pebarone/carrinho-tinyml/cp2/evidence/edge-impulse/01-impulse.jpg

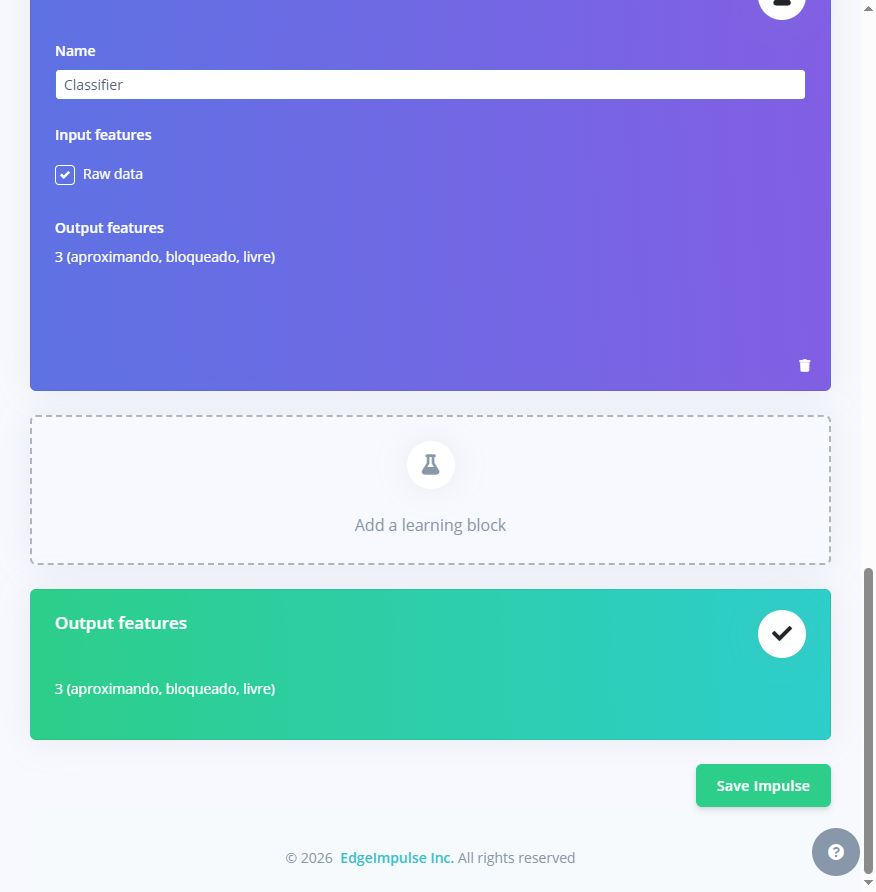
cp2/evidence/edge-impulse/01-impulse.jpg
