pebarone/carrinho-tinyml/cp2/evidence/edge-impulse/02-training.jpg

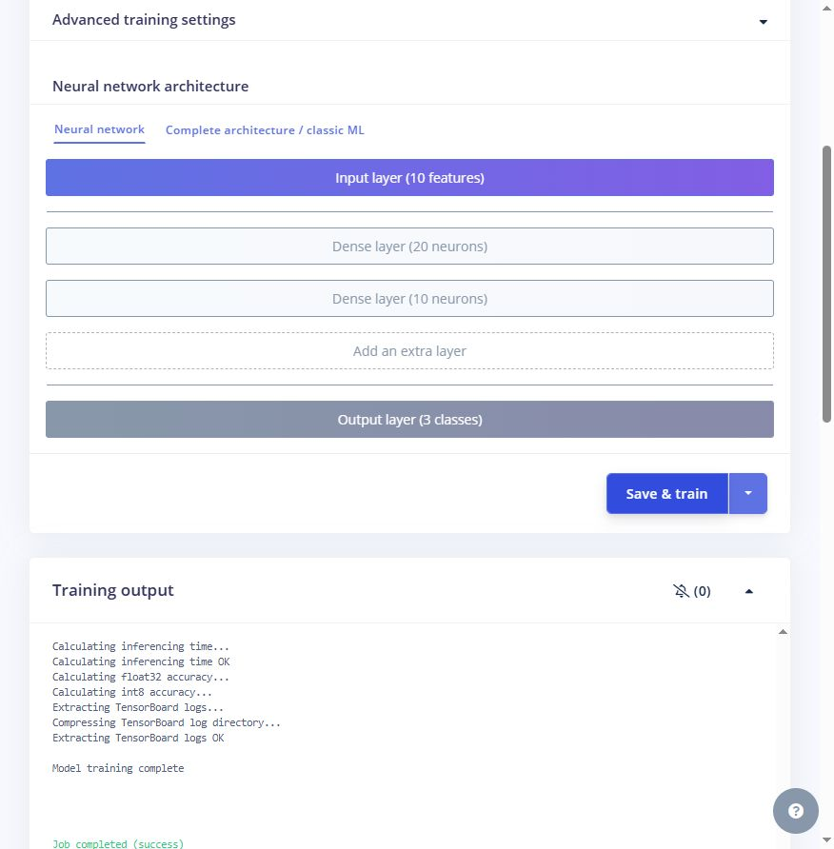
cp2/evidence/edge-impulse/02-training.jpg
