pebarone/carrinho-tinyml/cp2/evidence/real-training-v1/01-projeto-real.png

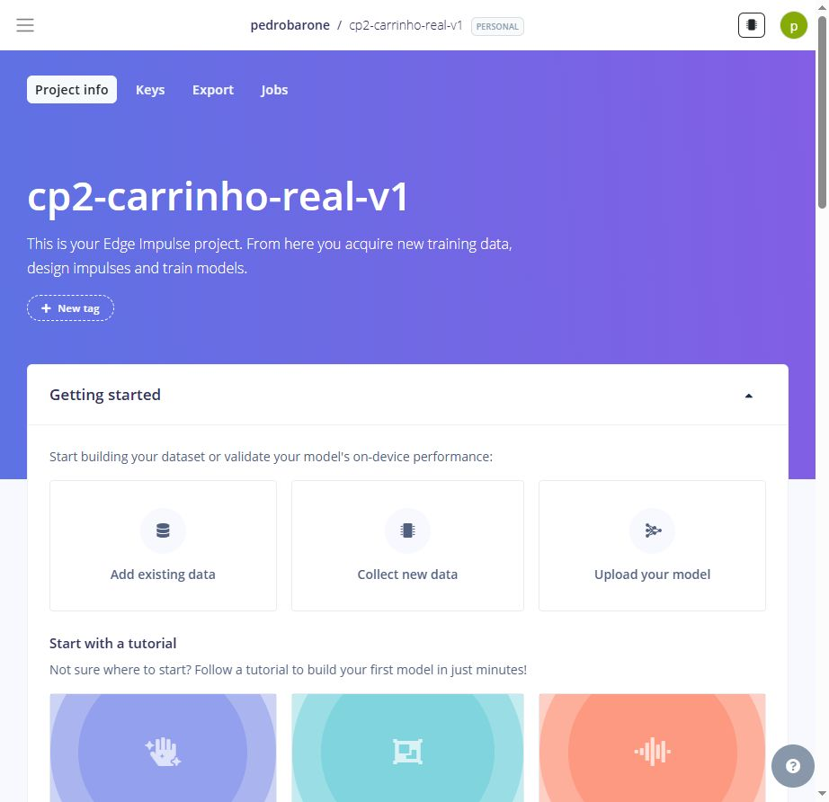
cp2/evidence/real-training-v1/01-projeto-real.png
