pebarone/carrinho-tinyml/cp2/evidence/real-training-v1/02-csv-wizard.png

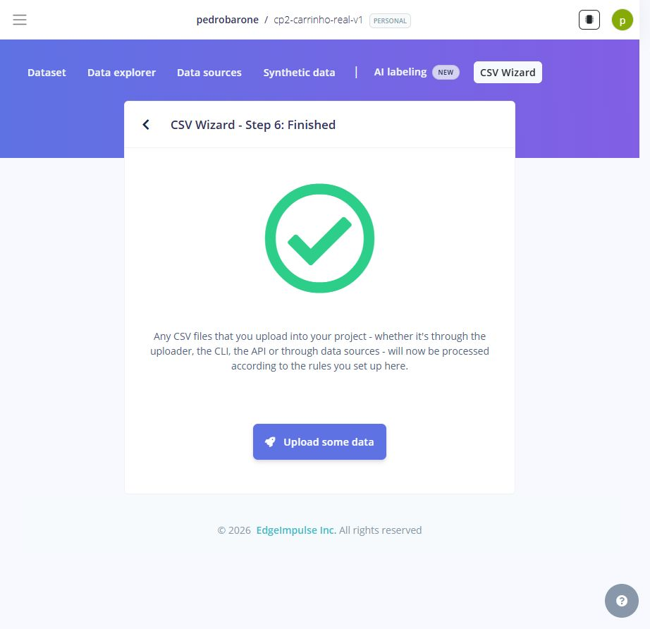
cp2/evidence/real-training-v1/02-csv-wizard.png
