pebarone/carrinho-tinyml/cp2/evidence/real-training-v1/03-dataset-real.png

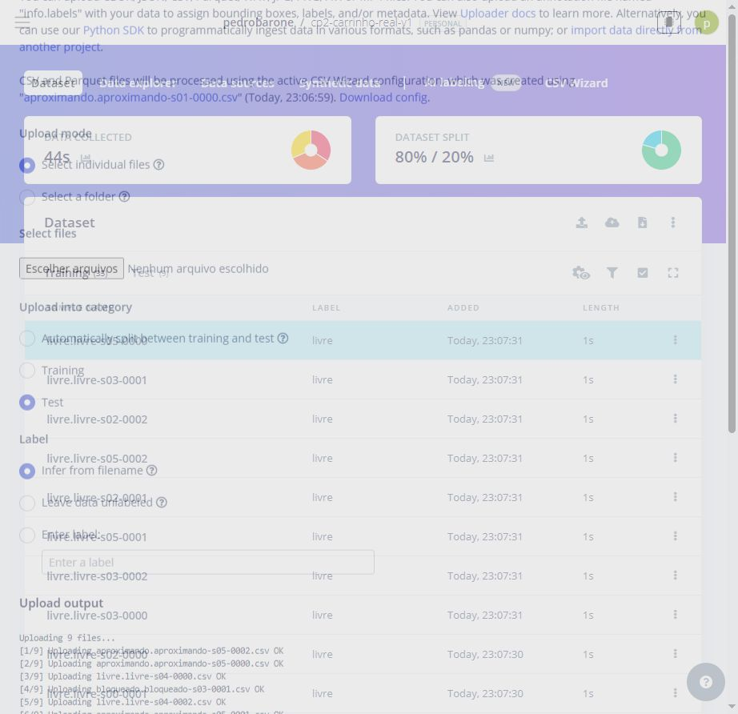
cp2/evidence/real-training-v1/03-dataset-real.png
