pebarone/carrinho-tinyml/cp2/evidence/real-training-v1/05-features.png

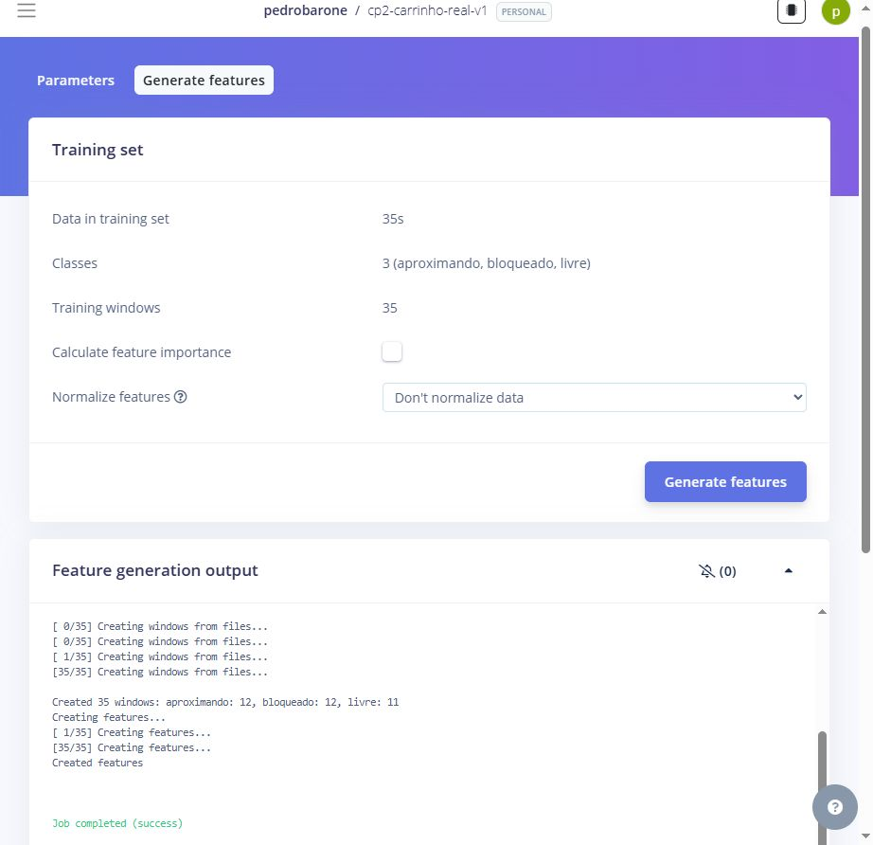
cp2/evidence/real-training-v1/05-features.png
