pebarone/carrinho-tinyml/cp2/evidence/real-training-v1/06-training-settings.png

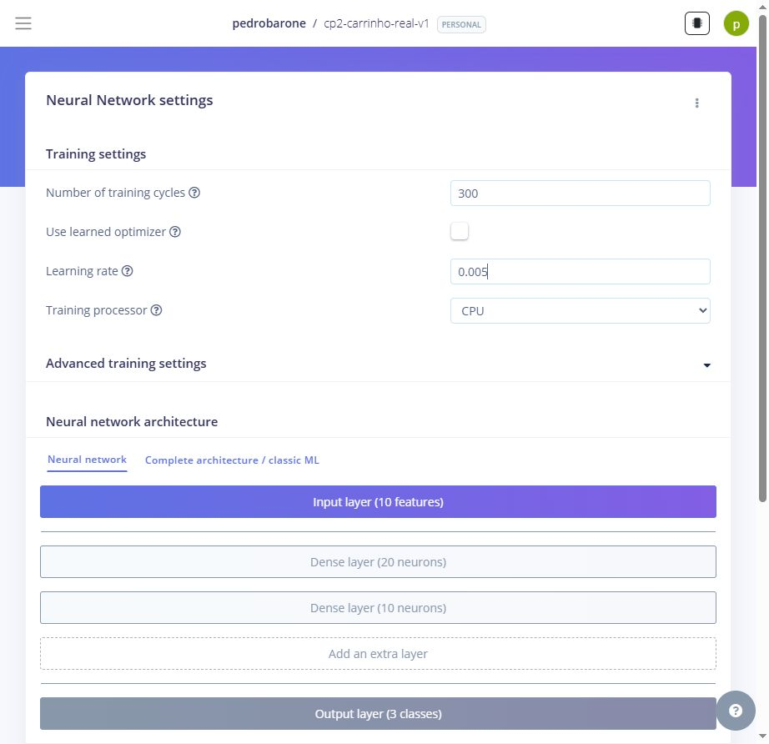
cp2/evidence/real-training-v1/06-training-settings.png
