pebarone/carrinho-tinyml/cp2/evidence/real-training-v1/10-projeto-publico.png

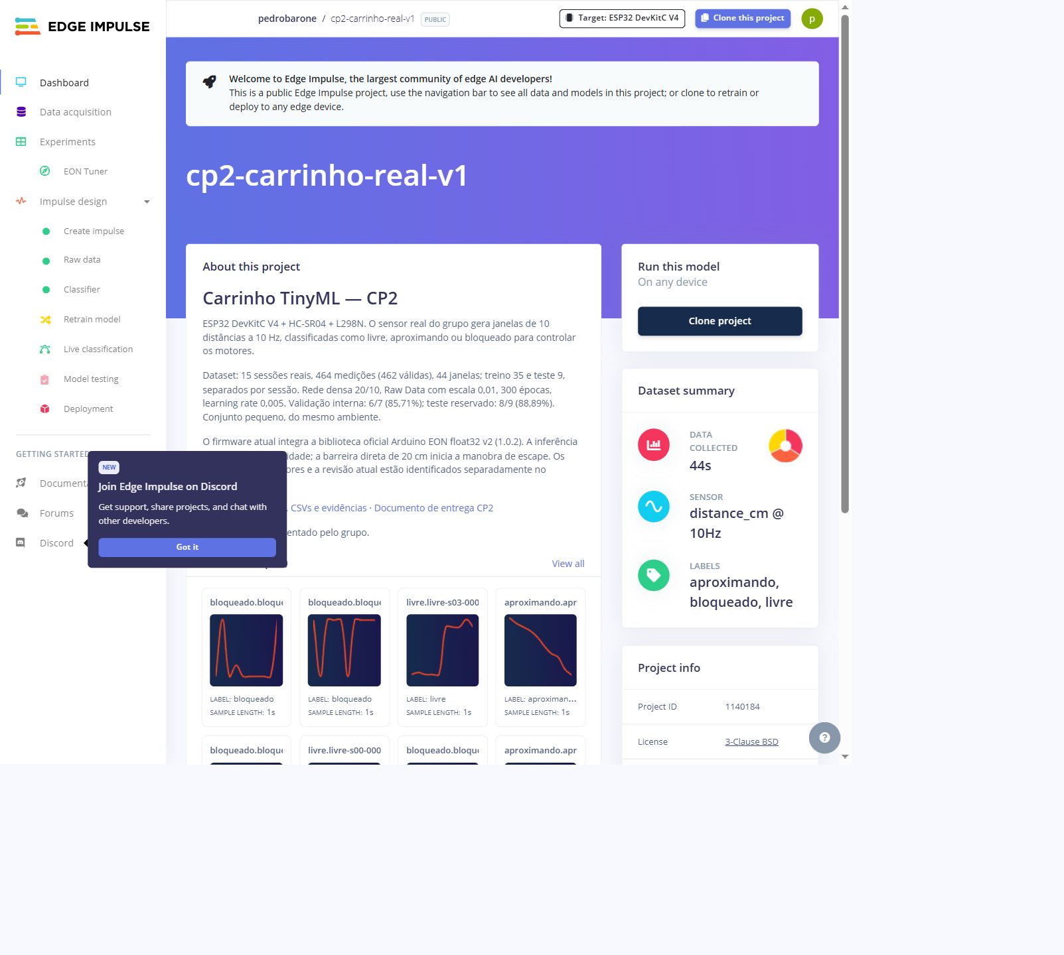
cp2/evidence/real-training-v1/10-projeto-publico.png
