pebarone/carrinho-tinyml/cp2/evidence/wokwi/01-collection.jpg

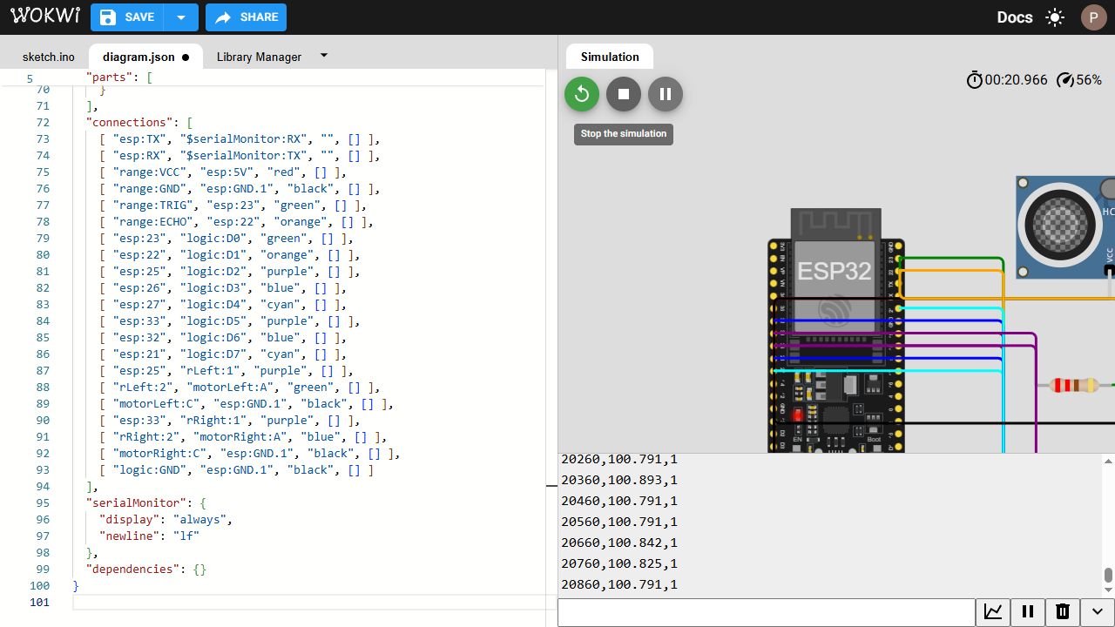
cp2/evidence/wokwi/01-collection.jpg
