pebarone/carrinho-tinyml/cp2/evidence/wokwi/02-free.jpg

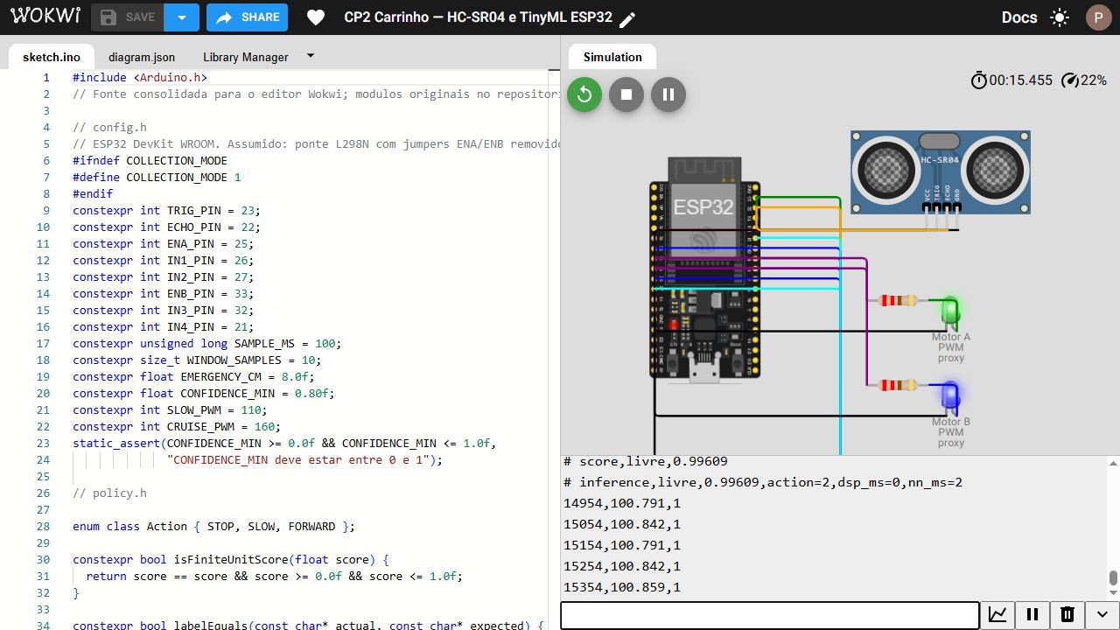
cp2/evidence/wokwi/02-free.jpg
