pebarone/carrinho-tinyml/knowledge_base/parte2/classifier_edge_impulse.png

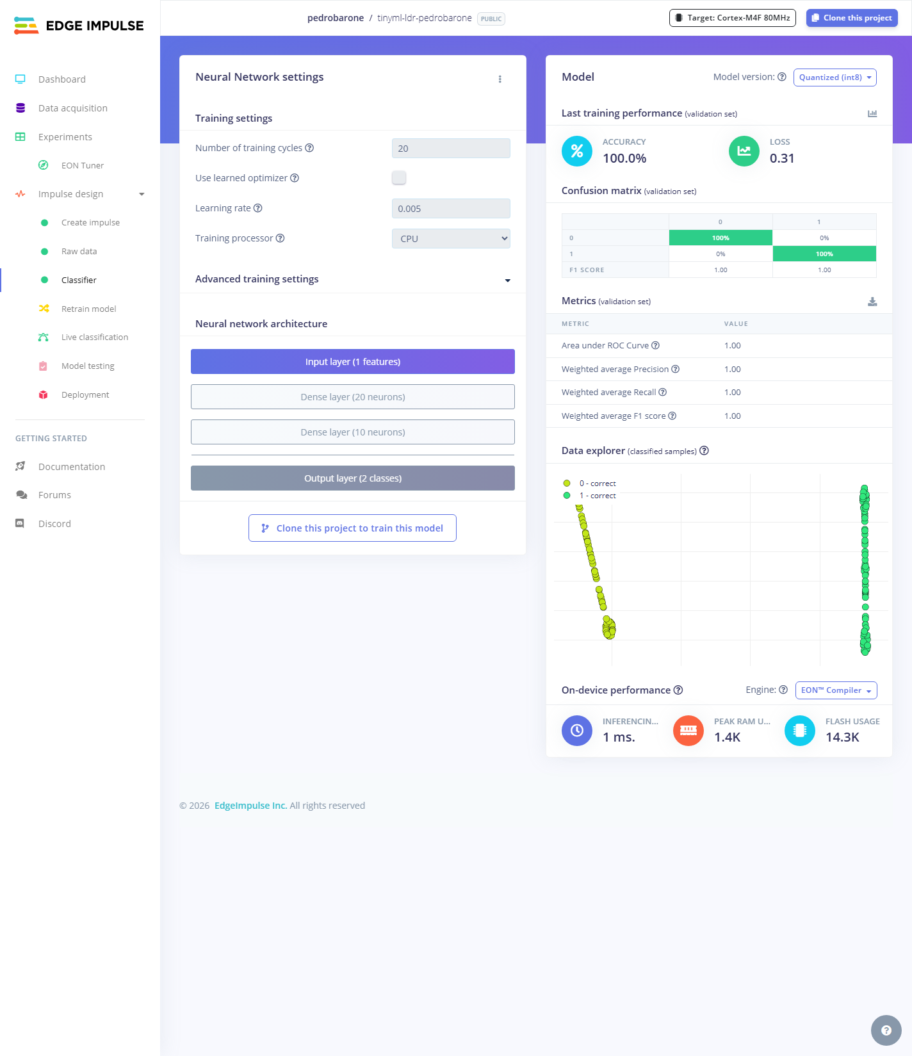
knowledge_base/parte2/classifier_edge_impulse.png
