pebarone/carrinho-tinyml/knowledge_base/parte2/diagnostico_treino_local_sintetico.png

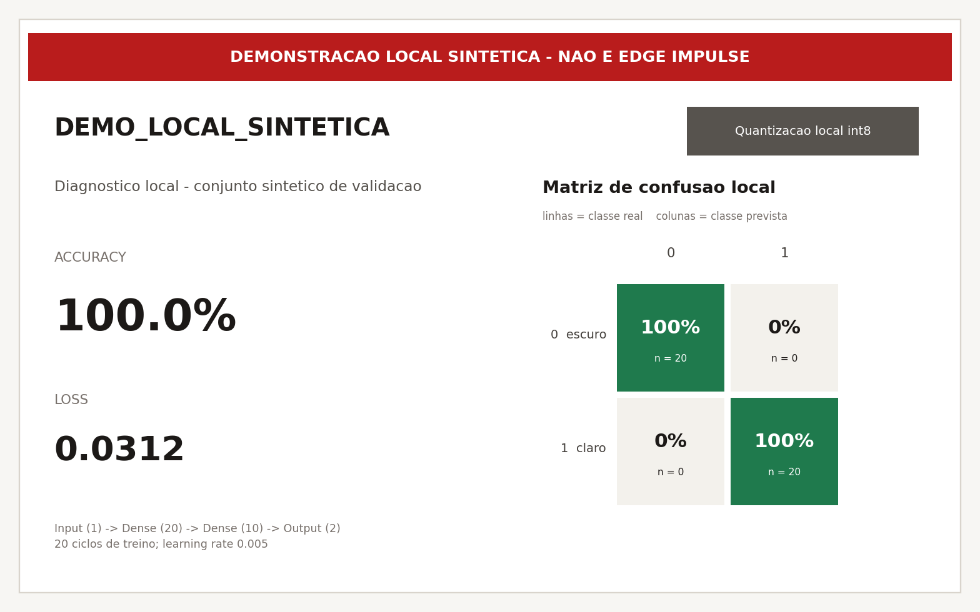
knowledge_base/parte2/diagnostico_treino_local_sintetico.png
