pebarone/carrinho-tinyml/media/preview_carrinho.gif

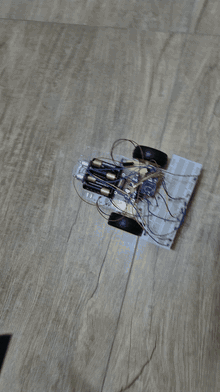
media/preview_carrinho.gif
