pebarone/carrinho-tinyml/cp2/docs/montagem.html

CP2 / CARRINHO TINYML

# Um suporte de pilhas. Dois resistores.

Ligação direta para ESP32 DevKitC V4, HC-SR04, L298N e dois motores, usando suas quatro AA recarregáveis de 1,2 V. Sem conversor e sem diodo.

Você mediu 5,5 V: ainda não conecte a eletrônica. Este desenho só serve para teste quando o suporte estiver entre 4,8 e 5,0 V, inclusive com a eletrônica ligada. A DevKitC V4 especifica entrada de 5 V; o sensor também é de 5 V. Com ECHO em 5,5 V, seus resistores deixam passar 3,67 V ao GPIO, acima de 3,6 V. Não há regulador de 5 V utilizável na L298N com essa tensão de entrada.

Positivo das pilhas → 5V da ESP32 + VCC do sensor + 5V da ponteUma emenda distribui a alimentação. Somente na faixa de teste de 4,8–5,0 V.

Mesmo positivo → Vs / 12V da ponte → motores“12V” é o nome do terminal. O negativo vai ao GND de todos.

O USB fica desconectado enquanto as pilhas alimentam a ESP32. A tensão das pilhas não é regulada: confira a cada recarga e interrompa o teste se sair da faixa, o sensor falhar ou a placa reiniciar. A faixa indicada é uma condição para ensaio; não garante autonomia nem partida dos motores.

O firmware arma automaticamente em 5 segundos. Ligar a alimentação ou RESET inicia a contagem. S para e cancela a partida; A rearma. Não conecte USB junto com esta alimentação para enviar comandos. A consulta Wi-Fi apenas mostra o estado. Mantenha as rodas suspensas ao energizar.

## Veja o caminho dos fios

Escolha um grupo para destacar as ligações.

TodasAlimentaçãoGNDSensorControle da ponteMotoresPilhas

### Todas as ligações

As linhas mostram os fios. Um ponto marca uma emenda; linhas que apenas cruzam não se conectam. Os números da ESP32 são GPIOs, não posições no conector.

## Monte nesta ordem

USB desconectado e suporte sem pilhas durante toda a montagem.

1. Confira a tensão antes de energizar.
  Com os 5,5 V que você mediu, pare aqui para a eletrônica. Este circuito não reduz a tensão. Só prossiga com suporte entre 4,8 e 5,0 V; não provoque descarga por curto-circuito.
2. Retire três jumpers da L298N.
  Retire 5V_EN, ENA e ENB. Os 5V da lógica serão uma entrada externa; ENA/ENB receberão PWM.
3. Una os negativos.
  Negativo do suporte → GND da ESP32, GND do sensor e GND da L298N.
4. Divida o positivo em quatro destinos.
  Positivo do suporte → 5V da DevKitC V4, VCC do HC-SR04, 5V e Vs / 12V da L298N. Use uma linha de distribuição; não passe a corrente dos motores pela ESP32. Não use 3V3.
5. Monte o divisor de dois resistores.
  ECHO → 660 Ω → ponto do GPIO 22. Desse ponto, 1325 Ω → GND. Ligue TRIG → GPIO 23.
6. Ligue os controles e os motores.
  Siga a tabela. Motor A entre OUT1/OUT2; motor B entre OUT3/OUT4. Os seis controles não precisam de resistores.
7. Teste com rodas suspensas.
  Com USB ausente, coloque as pilhas e meça a linha da eletrônica. Se sair de 4,8–5,0 V, desligue. Reinício da ESP32, erro do sensor ou falta de força exigem interromper o ensaio. Multímetro não detecta todos os picos causados pelos motores.
8. Para voltar ao USB, isole as pilhas da eletrônica.
  Remova os fios do positivo do suporte que alimentam ESP32, sensor e 5V da ponte. Só depois use o USB e seu 5V para sensor/lógica, como na montagem anterior. Nunca una as duas fontes. Ao religar, a partida automática reinicia a contagem de 5 segundos.

## De onde → para onde

Mapa da ESP32 DevKitC V4. Positivo comum somente com suporte na faixa de teste de 4,8–5,0 V; USB desconectado.
Origem | Destino
USB da ESP32 | Desconectado durante alimentação pelas pilhas
Positivo comum · 4,8–5,0 V | ESP32 · 5V (entrada), HC-SR04 · VCC, L298N · 5V e Vs/12V
ESP32 · GND | HC-SR04 · GND, L298N · GND e negativo das pilhas
HC-SR04 · TRIG | ESP32 · GPIO 23
HC-SR04 · ECHO | 660 Ω → ponto do GPIO 22; desse ponto, 1325 Ω → GND
L298N · ENA | ESP32 · GPIO 25
L298N · IN1 | ESP32 · GPIO 26
L298N · IN2 | ESP32 · GPIO 27
L298N · IN3 | ESP32 · GPIO 32
L298N · IN4 | ESP32 · GPIO 21
L298N · ENB | ESP32 · GPIO 33
L298N · OUT1 / OUT2 | Os dois fios do motor A
L298N · OUT3 / OUT4 | Os dois fios do motor B
Pilhas · positivo | Linha comum de alimentação (quatro destinos acima)
Pilhas · negativo | GND comum

O 5V alimenta a placa; o GPIO lê sinais de 3,3V. A entrada 5V da placa alimenta seu regulador de 3,3 V; isso não permite aplicar a tensão das pilhas no GPIO 22. Os resistores protegem essa entrada, não alimentam o motor.

## Seus resistores: 660 Ω e 1325 Ω

Use os valores que você mediu. Resistores não têm polaridade. O ponto central liga três coisas: o resistor de 660 Ω, o GPIO 22 e o resistor de 1325 Ω.

V no GPIO = V do ECHO × 1325 ÷ (660 + 1325)

Com ECHO em 5,0 V → 3,34 V. Com ECHO em 5,5 V → 3,67 V: não use.

O divisor reduz apenas o sinal ECHO. Ele não regula a alimentação. Um multímetro comum pode não registrar a tensão máxima de pulsos curtos; a média mostrada não comprova que o pico é seguro. 3,6 V é limite, não uma tensão de trabalho desejada.

## Confira antes de ligar

USB e pilhas desligados durante a montagem.ENA, ENB e 5V_EN sem jumpers.GNDs unidos, incluindo negativo das pilhas.Suporte e linha da eletrônica medidos entre 4,8 e 5,0 V.ECHO → 660 Ω → GPIO 22; 1325 Ω desse ponto ao GND.Motores só nas saídas OUT1/2 e OUT3/4.

O código atual arma automaticamente após 5 segundos. A revisão float32 precisa ser gravada antes de validar o comportamento atualizado. A serial trabalha em 115200 baud, mas USB e pilhas na entrada 5V não devem coexistir. O firmware inicia sozinho; para o ensaio sem interface serial, deixe a alimentação acessível para desligar.

A arma · S para e desarma. Leitura inválida para. Em até 20cm, para e inicia ré/giro; baixa confiança conhecida permite avanço cauteloso. Veja o comportamento vigente.

## O que os 5,5 V medidos significam

As quatro AA são de 4,8 V nominais, mas você mediu 5,5 V no suporte. A medição atual prevalece: não assuma que cairá para 5 V ao ligar. Sem componentes adicionais, esta montagem direta só pode ser ensaiada quando as condições de tensão acima forem atendidas. Não há garantia de funcionamento durante toda a descarga.

A L298N perde tensão entre as pilhas e os motores. A partida pode derrubar a alimentação da ESP32 e causar reinício. O regulador da ponte fica desativado: não serve para transformar os 5,5 V do suporte em 5 V estáveis.

Os guias Markdown e o Wokwi vinculados descrevem a montagem anterior com USB separado. Este HTML documenta a alternativa direta solicitada, ainda sem validação física.

Mapa correspondente a cp2/firmware/carrinho/config.h. O perfil atual usa o modelo treinado com dados reais 1140184, exportado em float32. A validação física desta revisão continua pendente. A montagem Wokwi é ilustrativa: o divisor resistivo produziu leituras inválidas no simulador e não é usado para validar inferência. Para os testes digitais, use a simulação original. Nenhum dos desenhos valida corrente dos motores, queda de tensão, autonomia ou proteção elétrica.

Guia anterior (USB separado)Próxima etapa físicaSimulação TinyML original (https://wokwi.com/projects/477821599079365633)Datasheet ESP32 (https://www.espressif.com/sites/default/files/documentation/esp32_datasheet_en.pdf)Datasheet L298 (https://www.st.com/resource/en/datasheet/l298.pdf)Alimentação DevKitC V4 (https://documentation.espressif.com/esp-dev-kits/en/latest/esp32/esp32-devkitc/user_guide.html)
