pebarone/carrinho-tinyml/cp2/evidence/assembly/guia-completo.png

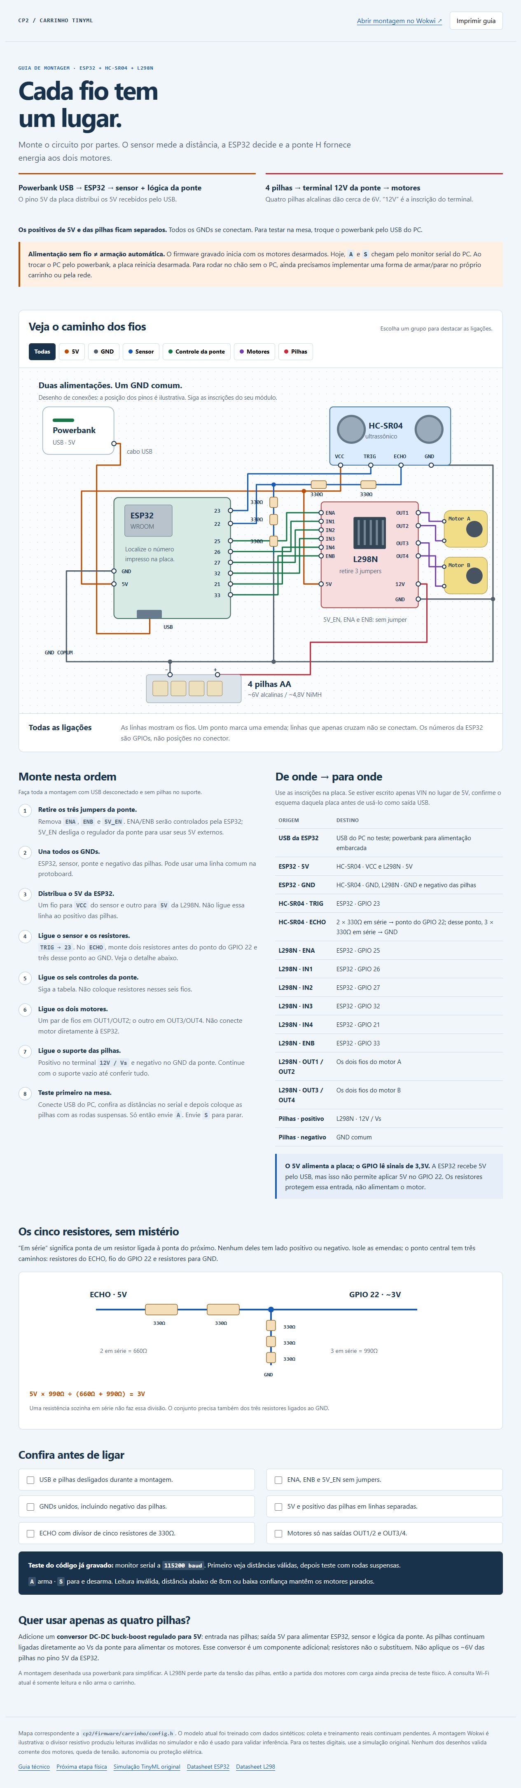
cp2/evidence/assembly/guia-completo.png
