pebarone/carrinho-tinyml/cp2/data/real/calibration/alvo-20cm-s00.csv

timestamp | distance_cm | valid
1720 | 14.646 | 1
1820 | 14.646 | 1
1920 | 14.646 | 1
2020 | 14.646 | 1
2120 | 14.646 | 1
2220 | 14.646 | 1
2320 | 14.646 | 1
2420 | 14.646 | 1
2520 | 14.629 | 1
2620 | 14.646 | 1
2720 | 14.646 | 1
2820 | 14.646 | 1
2920 | 14.629 | 1
3020 | 14.646 | 1
3120 | 14.646 | 1
3220 | 14.56 | 1
3320 | 14.56 | 1
3420 | 14.646 | 1
3520 | 14.56 | 1
3620 | 14.629 | 1
3720 | 14.56 | 1
3820 | 14.56 | 1
3920 | 14.629 | 1
4020 | 14.56 | 1
4120 | 14.56 | 1
4220 | 14.56 | 1
4320 | 14.56 | 1
4420 | 14.56 | 1
4520 | 14.56 | 1
4620 | 14.646 | 1
4720 | 14.56 | 1
4820 | 14.56 | 1
4920 | 14.56 | 1
5020 | 14.646 | 1
5120 | 14.646 | 1
5220 | 14.646 | 1
5320 | 14.646 | 1
5420 | 14.646 | 1
5520 | 14.56 | 1
5620 | 14.56 | 1
5720 | 14.646 | 1
5820 | 14.646 | 1
5920 | 14.56 | 1
6020 | 14.56 | 1
6120 | 14.56 | 1
6220 | 14.646 | 1
6320 | 14.56 | 1
6420 | 14.646 | 1
6520 | 14.56 | 1
6620 | 14.56 | 1
6720 | 14.56 | 1
6820 | 14.56 | 1
6920 | 14.56 | 1
7020 | 14.56 | 1
7120 | 14.56 | 1
7220 | 14.56 | 1
7320 | 14.56 | 1
7420 | 14.56 | 1
7520 | 14.56 | 1
7620 | 14.56 | 1
7720 | 14.56 | 1
7820 | 14.56 | 1
7920 | 14.646 | 1
8020 | 14.56 | 1
8120 | 14.56 | 1
8220 | 14.56 | 1
8320 | 14.56 | 1
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
