pebarone/carrinho-tinyml/cp2/data/real/calibration/alvo-40cm-s00.csv

timestamp | distance_cm | valid
57120 | 45.653 | 1
57220 | 44.796 | 1
57320 | 44.796 | 1
57420 | 45.207 | 1
57520 | 45.207 | 1
57620 | 45.225 | 1
57720 | 45.225 | 1
57820 | 45.225 | 1
57920 | 45.207 | 1
58020 | 45.225 | 1
58120 | 44.796 | 1
58220 | 44.796 | 1
58320 | 45.207 | 1
58420 | 44.796 | 1
58520 | 44.796 | 1
58620 | 45.225 | 1
58720 | 44.71 | 1
58820 | 45.139 | 1
58920 | 45.036 | 1
59020 | 44.521 | 1
59120 | 44.521 | 1
59220 | 43.938 | 1
59320 | 44.71 | 1
59420 | 43.938 | 1
59520 | 43.938 | 1
59620 | 44.71 | 1
59720 | 44.281 | 1
59820 | 43.853 | 1
59920 | 43.938 | 1
60020 | 43.853 | 1
60120 | 43.921 | 1
60220 | 43.921 | 1
60320 | 43.938 | 1
60420 | 44.367 | 1
60520 | 44.367 | 1
60620 | 43.595 | 1
60720 | 44.367 | 1
60820 | 44.367 | 1
60920 | 44.024 | 1
61020 | 44.367 | 1
61120 | 43.595 | 1
61220 | 44.041 | 1
61320 | 44.453 | 1
61420 | 44.024 | 1
61520 | 44.024 | 1
61620 | 44.024 | 1
61720 | 44.453 | 1
61820 | 44.367 | 1
61920 | 44.367 | 1
62020 | 44.367 | 1
62120 | 44.367 | 1
62220 | 43.938 | 1
62320 | 44.367 | 1
62420 | 43.921 | 1
62520 | 43.938 | 1
62620 | 43.921 | 1
62720 | 43.853 | 1
62820 | 43.835 | 1
62920 | 44.196 | 1
63020 | 43.767 | 1
63120 | 43.767 | 1
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
