pebarone/carrinho-tinyml/cp2/data/real/calibration/alvo-80cm-s00.csv

timestamp | distance_cm | valid
159720 | 68.291 | 1
159820 | 69.492 | 1
159920 | 67.863 | 1
160020 | 67.434 | 1
160120 | 68.617 | 1
160220 | 67.863 | 1
160320 | 69.56 | 1
160420 | 67.88 | 1
160520 | 68.274 | 1
160620 | 67.863 | 1
160720 | 68.771 | 1
160820 | 67.948 | 1
160920 | 68.771 | 1
161020 | 68.806 | 1
161120 | 67.914 | 1
161220 | 68.377 | 1
161320 | 68.0 | 1
161420 | 67.605 | 1
161520 | 68.377 | 1
161620 | 68.377 | 1
161720 | 68.034 | 1
161820 | 68.463 | 1
161920 | 68.12 | 1
162020 | 68.463 | 1
162120 | 68.446 | 1
162220 | 67.708 | 1
162320 | 69.303 | 1
162420 | 68.892 | 1
162520 | 68.034 | 1
162620 | 68.463 | 1
162720 | 68.806 | 1
162820 | 68.806 | 1
162920 | 68.034 | 1
163020 | 67.948 | 1
163120 | 68.394 | 1
163220 | 67.965 | 1
163320 | 68.72 | 1
163420 | 67.965 | 1
163520 | 68.806 | 1
163620 | 67.948 | 1
163720 | 68.377 | 1
163820 | 67.948 | 1
163920 | 68.377 | 1
164020 | 68.051 | 1
164120 | 68.394 | 1
164220 | 67.948 | 1
164320 | 67.948 | 1
164420 | 68.806 | 1
164520 | 68.806 | 1
164620 | 68.789 | 1
164720 | 69.235 | 1
164820 | 68.789 | 1
164920 | 68.806 | 1
165020 | 68.771 | 1
165120 | 67.622 | 1
165220 | 69.235 | 1
165320 | 68.806 | 1
165420 | 68.463 | 1
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
