pebarone/carrinho-tinyml/cp2/data/real/edge-impulse-v1/testing/aproximando.aproximando-s05-0000.csv

timestamp | distance_cm
0 | 49.032
100 | 48.517
200 | 50.147
300 | 48.946
400 | 48.946
500 | 49.718
600 | 48.946
700 | 49.032
800 | 50.129
900 | 48.517
