pebarone/carrinho-tinyml/cp2/data/real/edge-impulse-v1/testing/aproximando.aproximando-s05-0001.csv

timestamp | distance_cm
0 | 47.231
100 | 46.305
200 | 45.276
300 | 44.864
400 | 41.966
500 | 40.851
600 | 41.452
700 | 38.725
800 | 37.456
900 | 36.015
