pebarone/carrinho-tinyml/cp2/data/real/edge-impulse-v1/testing/aproximando.aproximando-s05-0002.csv

timestamp | distance_cm
0 | 35.329
100 | 33.288
200 | 31.762
300 | 30.819
400 | 29.018
500 | 27.406
600 | 26.051
700 | 25.193
800 | 24.01
900 | 23.238
