pebarone/carrinho-tinyml/cp2/evidence/edge-impulse/03-test-float32.jpg

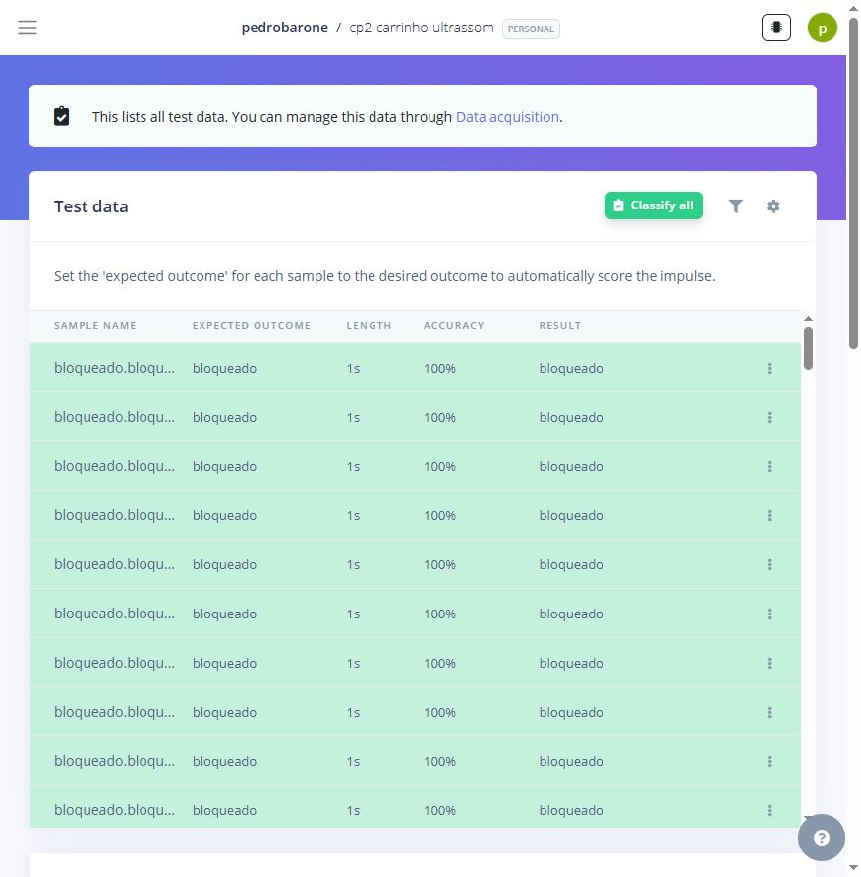
cp2/evidence/edge-impulse/03-test-float32.jpg
