pebarone/carrinho-tinyml/cp2/evidence/edge-impulse/04-test-int8.jpg

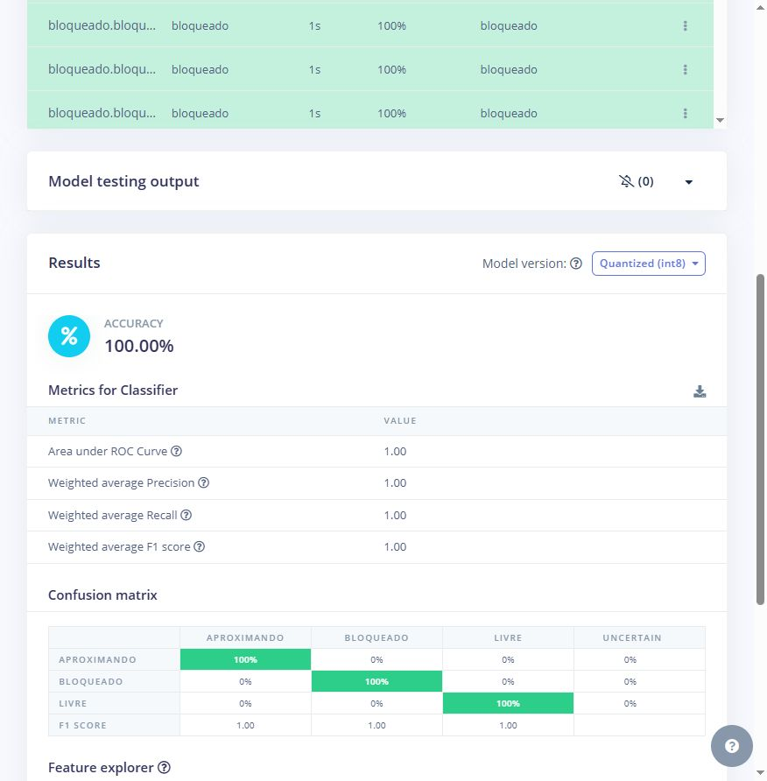
cp2/evidence/edge-impulse/04-test-int8.jpg
