pebarone/carrinho-tinyml/cp2/evidence/real-training-v1/08-test-float32.png

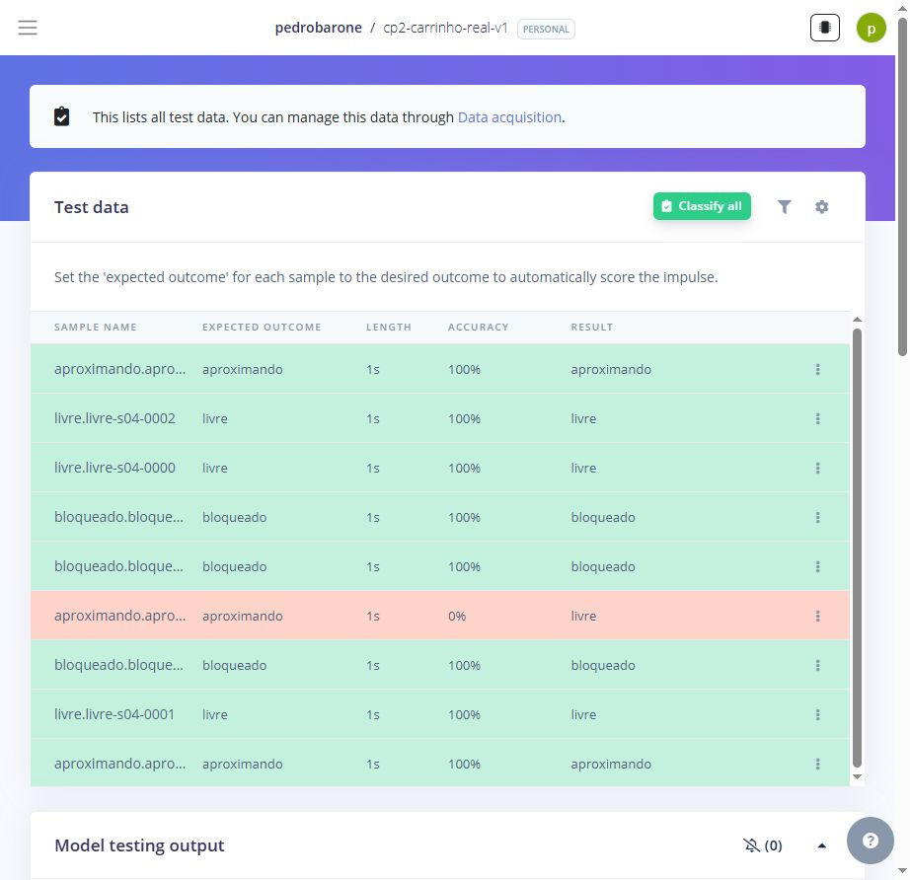
cp2/evidence/real-training-v1/08-test-float32.png
