pebarone/carrinho-tinyml/cp2/evidence/real-training-v1/09-test-int8.png

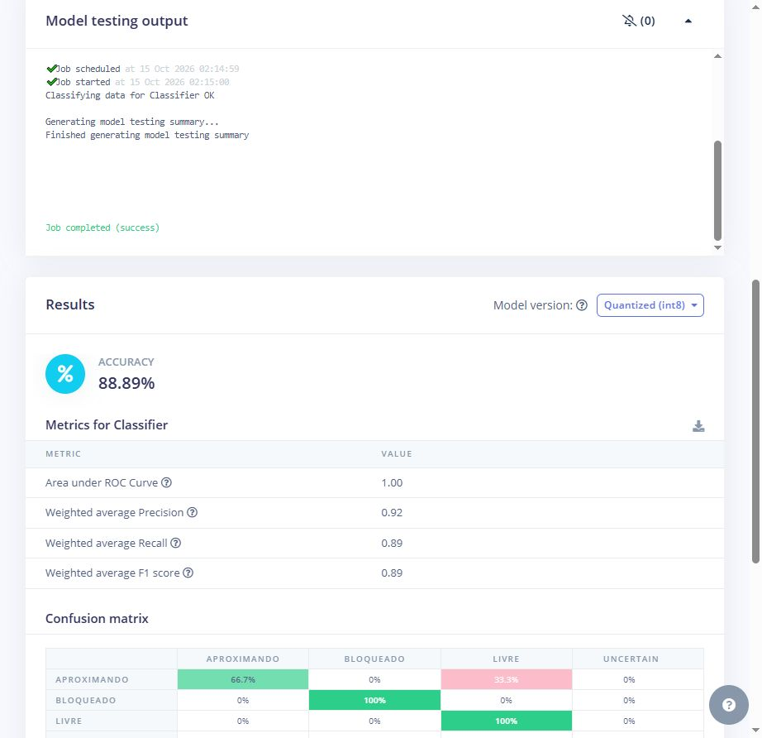
cp2/evidence/real-training-v1/09-test-int8.png
