pebarone/carrinho-tinyml/(commit log)

2026-10-14 feat(cp1): add reconstructed ultrasonic threshold baseline
2026-10-14 feat(cp2): add modular TinyML firmware and provenance-aware dataset pipeline
    [aproximando-s00.csv, aproximando-s01.csv, aproximando-s02.csv, aproximando-s03.csv, aproximando-s04.csv, aproximando-s05.csv, aproximando-s06.csv, aproximando-s07.csv]
2026-10-14 feat(ml): export Edge Impulse int8 model and preserve official evaluation evidence
    [aproximando-s00.csv, aproximando-s01.csv, aproximando-s02.csv, aproximando-s03.csv, aproximando-s04.csv, aproximando-s05.csv, aproximando-s06.csv, aproximando-s07.csv]
2026-10-14 docs(reference): preserve prior LDR exercise separately from car project
    [dados.csv, leituras_brutas.csv]
2026-10-14 test(cp2): verify Edge Impulse motor actions on Wokwi ESP32
2026-10-14 docs(cp2): document wiring, training, simulation evidence and team delivery
2026-10-14 feat(cp2): flash physical ESP32 and add optional hotspot status endpoint
2026-10-14 docs(cp2): simplify USB power and wiring with 330 ohm resistors
2026-10-14 docs(cp2): add interactive assembly guide and separate Wokwi wiring map
    [motor.chip.json]
2026-10-21 data(cp2): preserve real sensor sessions and Edge Impulse training evidence
    [alvo-20cm-s00.csv, alvo-40cm-s00.csv, alvo-80cm-s00.csv, aproximando-s00.csv, aproximando-s01.csv, aproximando-s02.csv, aproximando-s03.csv, aproximando-s04.csv]
2026-10-21 feat(cp2): integrate real float32 model and autonomous motor control
